rene2997/adaptive_fpu/README.md

# Adaptive FPU
An adaptive that is integrated into the Wildcat design as an optional extension that handles floating-point operations. It is memory-mapped and controlled a via a memory arbiter. This enables the processor to offload FP computations while maintaning a simple, modular interface.

## Compile
To run setup the docker environment for x86_64 architectures you need to build and then run it. 
```bash
docker build -t wildcat-env .
````
```bash
docker run -it -v $(pwd):/app wildcat-env
````

For amd64 architectures use the following commands instead.
```bash
docker build --platform=linux/amd64 -t wildcat-env .
````
```bash
docker run --platform=linux/amd64 -it -v $(pwd):/app wildcat-env
````

## Test in verilator and gtkwave
To utilize verilator for testing the fpu and the memory_arbiter you need to utilize the makefile.
```bash
cd verilator
make test-mem
```

For a graphical waveform representation gtkwave can be utilized if the aditional parameters are used in the docker initialization.
```bash
docker run -it \
  --env DISPLAY=$DISPLAY \
  --volume /tmp/.X11-unix:/tmp/.X11-unix \
  -v $(pwd):/app \
  wildcat-env \
  bash
```

## TCL-script in Vivado

To run the TCL-script ensure that Vivado is in your system path. The command prompt is needed for this. 
```bash
vivado -mode batch -source setup.tcl
```
