rene2997/adaptive_fpu/clockInfo.txt

-------------------------------------
| Tool Version : Vivado v.2024.2.1
| Date         : Wed Apr  2 08:55:32 2025
| Host         : DESKTOP-M304UT7
| Design       : design_1
| Device       : xc7a35t-cpg236-1--
-------------------------------------

For more information on clockInfo.txt clock routing debug file see https://support.xilinx.com/s/article/000035660?language=en_US
