rene2997/adaptive_fpu/adaptive_fpu/clockInfo.txt

-------------------------------------
| Tool Version : Vivado v.2024.2.1
| Date         : Tue Apr 29 17:17:17 2025
| Host         : DESKTOP-M304UT7
| Design       : impl_1
| Device       : xc7a35t-cpg236-1--
-------------------------------------

For more information on clockInfo.txt clock routing debug file see https://support.xilinx.com/s/article/000035660?language=en_US
