rene2997/adaptive_fpu/adaptive_fpu/tight_setup_hold_pins.txt

+====================+===================+========================+
| Launch Setup Clock | Launch Hold Clock | Pin                    |
+====================+===================+========================+
| sys_clk_pin        | sys_clk_pin       | tx/buf_/stateReg_reg/D |
+--------------------+-------------------+------------------------+
