rene2997/adaptive_fpu/adaptive_fpu/adaptive_fpu.srcs/sources_1/imports/adaptive_fpu/adaptive_fpu/adaptive_fpu.srcs/sources_1/new/fpu_wrapper.sv

module fpu_wrapper (
    input clock,
    input reset,
    input start,
    input [1:0] op,
    input [31:0] a,
    input [31:0] b,
    output reg [31:0] result,
    output reg done

);
//synthesis translate off
always @(posedge clk) begin    
    valid <= 1'b1;
    out <= a + b;
end
//synthesis translate on
endmodule
