rene2997/adaptive_fpu/adaptive_fpu_out_of_context/adaptive_fpu_out_of_context.srcs/sources_1/imports/fpu_standard/fpu.sv

module fpu (
    input clk,
    input [31:0] a,
    input [31:0] b,
    input [1:0] op,
    output reg [31:0] result,
    output reg done

);
always @(posedge clk) begin    
    done <= 1'b1;
    result <= a + b;
end
endmodule
