rene2997/adaptive_fpu/(commit log)

2025-04-17 Verilator tests working in docker env
    [fpu_edge_cases_correct.csv]
2025-04-17 update test vecs
    [fpu_edge_cases_correct.csv]
2025-04-17 update edge_case vectors
    [fpu_edge_cases_correct.csv]
2025-04-19 Extending makefile to support binary compilation
    [fpu_edge_cases_correct.csv]
2025-04-20 Working test of the entire fpu + cpu
    [fpu_edge_cases_correct.csv]
